Yamil-Serrano/16-Bit-Address-Accumulator-Register/KiCad/Address Accumulator Register.kicad_pcb

## KiCad design KiCad/Address Accumulator Register.kicad_pcb (2026-10-30)

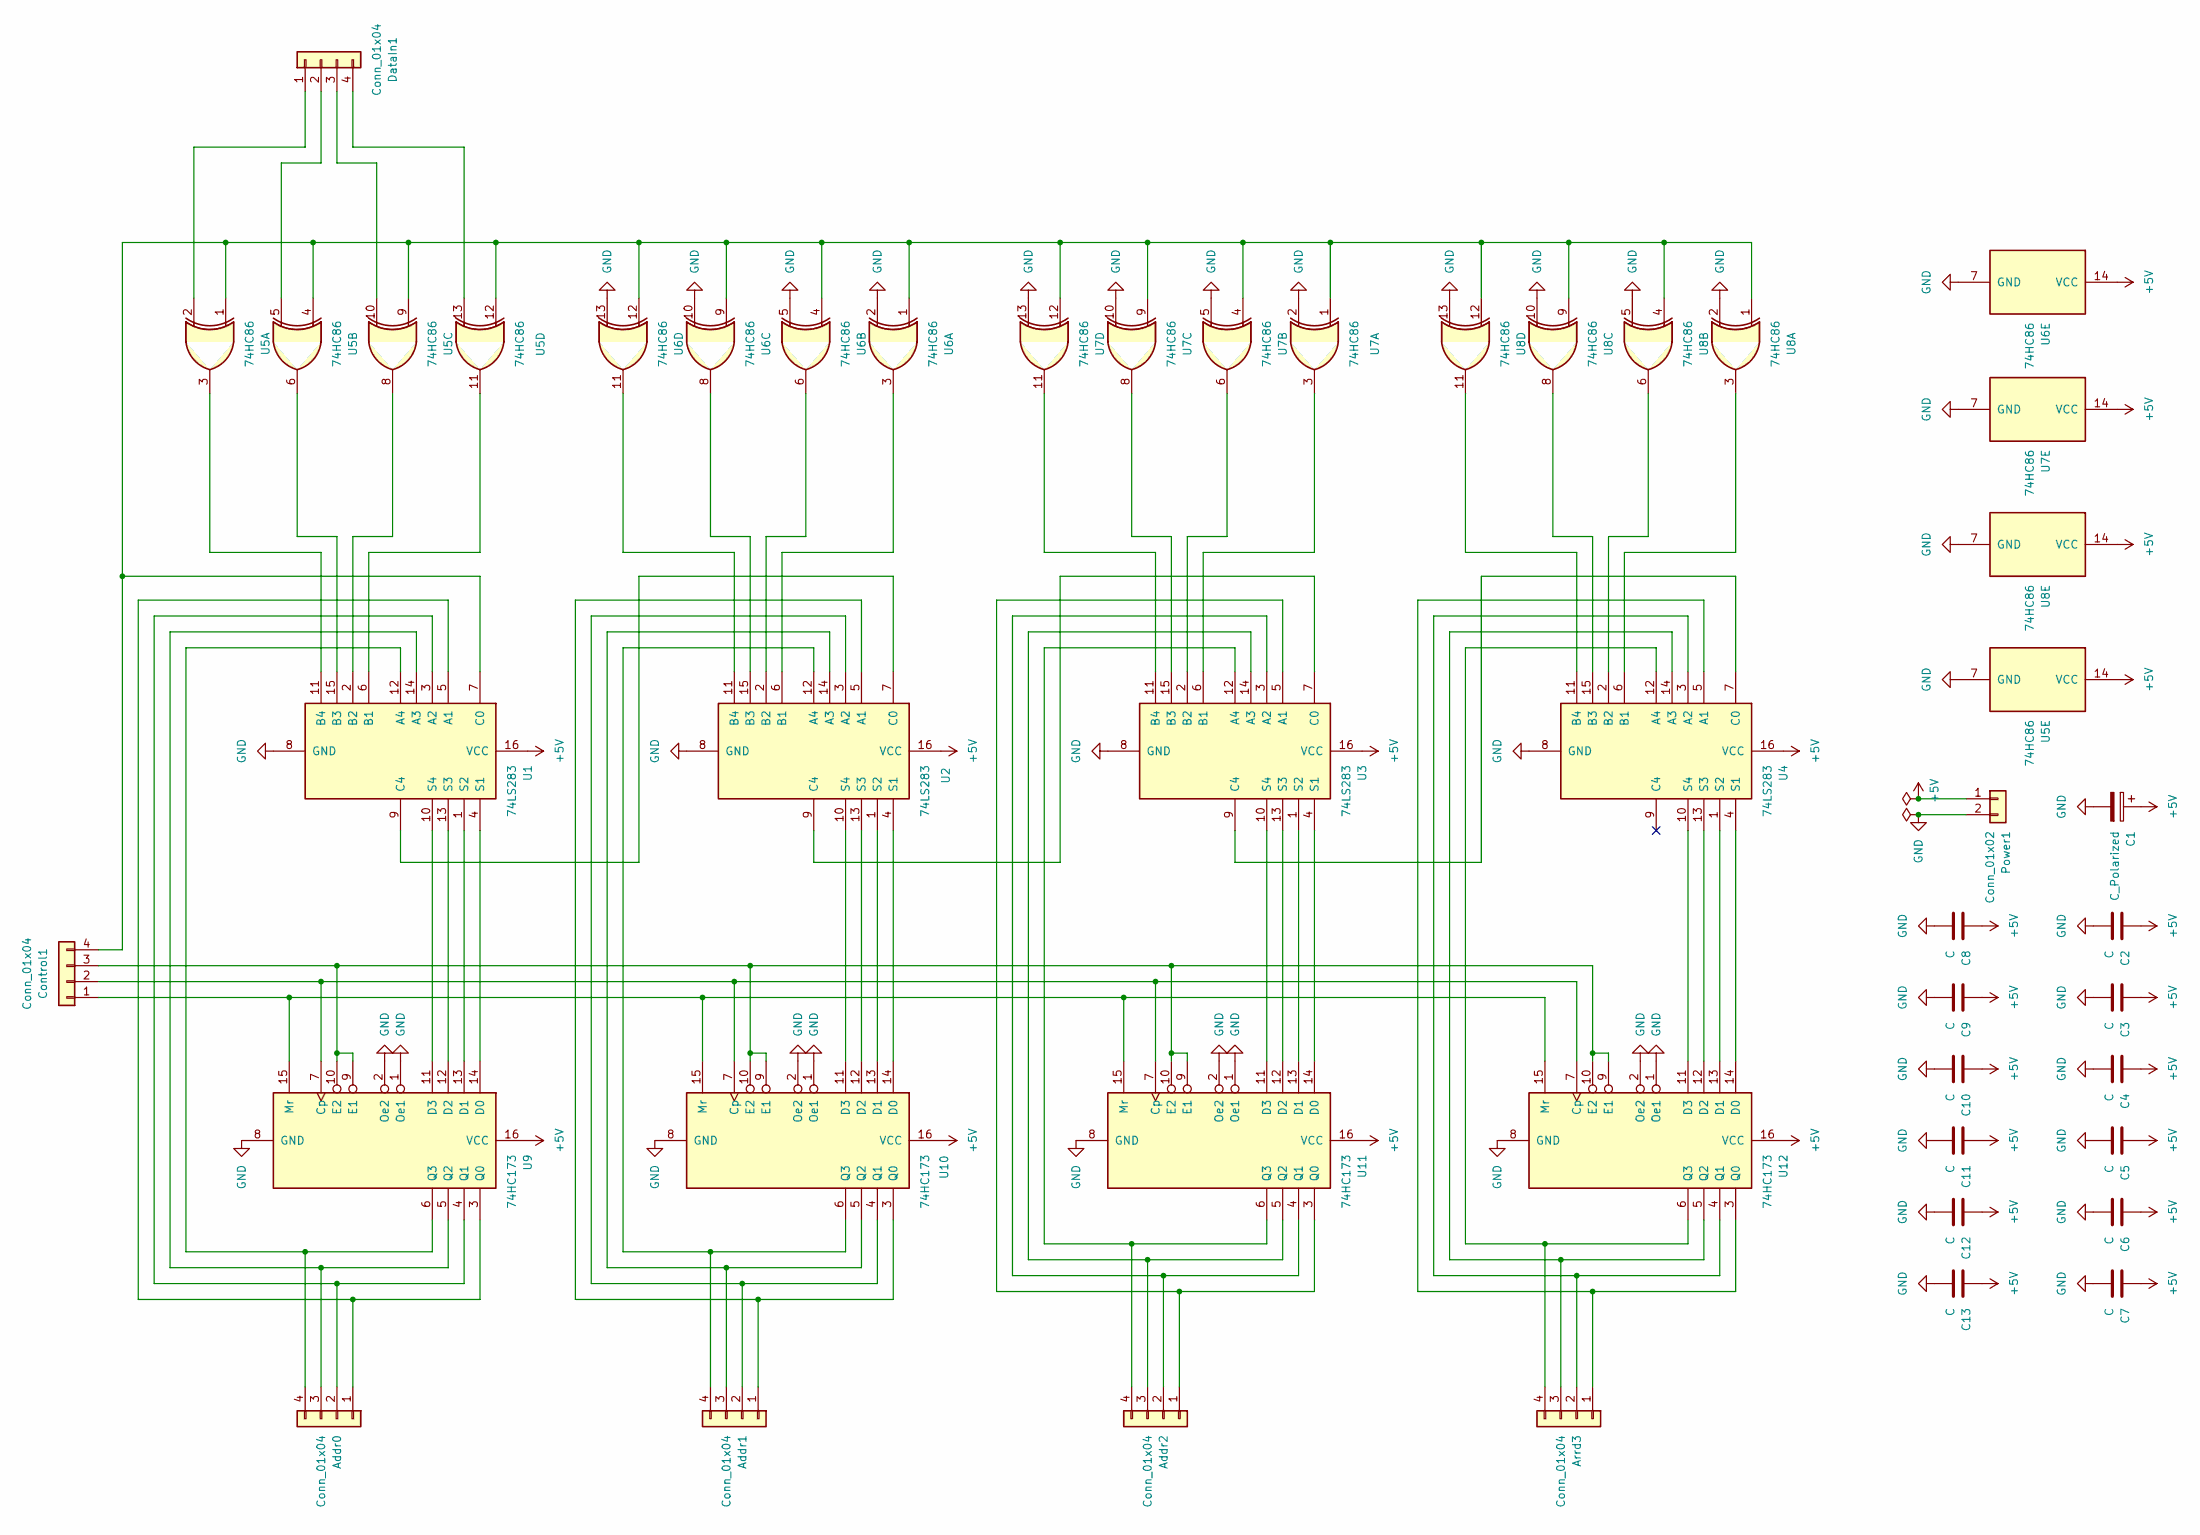
[picture p1: schematic Address Accumulator Register.kicad_sch, 16-Bit Address Accumulator Register]

Parts:
Addr0, Addr1, Addr2: Conn_01x04; PinHeader_1x04_P2.54mm_Vertical
Arrd3: Conn_01x04; PinHeader_1x04_P2.54mm_Vertical
C1: C_Polarized; CP_Radial_D4.0mm_P1.50mm
C2, C3, C4, C5, C6, C7, C8, C9, C10, C11, C12, C13: C; C_Disc_D3.0mm_W1.6mm_P2.50mm
Control1: Conn_01x04; PinHeader_1x04_P2.54mm_Vertical
DataIn1: Conn_01x04; PinHeader_1x04_P2.54mm_Vertical
Power1: Conn_01x02; PinHeader_1x02_P2.54mm_Vertical
U1, U2, U3, U4: 74LS283; DIP-16_W7.62mm_Socket
U5, U6, U7, U8: 74HC86; DIP-14_W7.62mm_Socket
U9, U10, U11, U12: 74HC173; DIP-16_W7.62mm_Socket

Connections:
+5V: C1.1, C2.1, C3.1, C4.1, C5.1, C6.1, C7.1, C8.1, C9.1, C10.1, C11.1, C12.1, C13.1, Power1.1, U1.16 (VCC), U2.16 (VCC), U3.16 (VCC), U4.16 (VCC), U5.14 (VCC), U6.14 (VCC), U7.14 (VCC), U8.14 (VCC), U9.16 (VCC), U10.16 (VCC), U11.16 (VCC), U12.16 (VCC)
GND: C1.2, C2.2, C3.2, C4.2, C5.2, C6.2, C7.2, C8.2, C9.2, C10.2, C11.2, C12.2, C13.2, Power1.2, U1.8 (GND), U2.8 (GND), U3.8 (GND), U4.8 (GND), U5.7 (GND), U6.2, U6.5, U6.7 (GND), U6.10, U6.13, U7.2, U7.5, U7.7 (GND), U7.10, U7.13, U8.2, U8.5, U8.7 (GND), U8.10, U8.13, U9.1 (Oe1), U9.2 (Oe2), U9.8 (GND), U10.1 (Oe1), U10.2 (Oe2), U10.8 (GND), U11.1 (Oe1), U11.2 (Oe2), U11.8 (GND), U12.1 (Oe1), U12.2 (Oe2), U12.8 (GND)
unnamed: Addr0.1, U1.5 (A1), U9.3 (Q0)
unnamed: Addr0.2, U1.3 (A2), U9.4 (Q1)
unnamed: Addr0.3, U1.14 (A3), U9.5 (Q2)
unnamed: Addr0.4, U1.12 (A4), U9.6 (Q3)
unnamed: Addr1.1, U2.5 (A1), U10.3 (Q0)
unnamed: Addr1.2, U2.3 (A2), U10.4 (Q1)
unnamed: Addr1.3, U2.14 (A3), U10.5 (Q2)
unnamed: Addr1.4, U2.12 (A4), U10.6 (Q3)
unnamed: Addr2.1, U3.5 (A1), U11.3 (Q0)
unnamed: Addr2.2, U3.3 (A2), U11.4 (Q1)
unnamed: Addr2.3, U3.14 (A3), U11.5 (Q2)
unnamed: Addr2.4, U3.12 (A4), U11.6 (Q3)
unnamed: Arrd3.1, U4.5 (A1), U12.3 (Q0)
unnamed: Arrd3.2, U4.3 (A2), U12.4 (Q1)
unnamed: Arrd3.3, U4.14 (A3), U12.5 (Q2)
unnamed: Arrd3.4, U4.12 (A4), U12.6 (Q3)
unnamed: Control1.1, U9.15 (Mr), U10.15 (Mr), U11.15 (Mr), U12.15 (Mr)
unnamed: Control1.2, U9.7 (Cp), U10.7 (Cp), U11.7 (Cp), U12.7 (Cp)
unnamed: Control1.3, U9.9 (E1), U9.10 (E2), U10.9 (E1), U10.10 (E2), U11.9 (E1), U11.10 (E2), U12.9 (E1), U12.10 (E2)
unnamed: Control1.4, U1.7 (C0), U5.1, U5.4, U5.9, U5.12, U6.1, U6.4, U6.9, U6.12, U7.1, U7.4, U7.9, U7.12, U8.1, U8.4, U8.9, U8.12
unnamed: DataIn1.1, U5.2
unnamed: DataIn1.2, U5.5
unnamed: DataIn1.3, U5.10
unnamed: DataIn1.4, U5.13
unnamed: U1.6 (B1), U5.11
unnamed: U1.2 (B2), U5.8
unnamed: U1.15 (B3), U5.6
unnamed: U1.11 (B4), U5.3
unnamed: U1.9 (C4), U2.7 (C0)
unnamed: U1.4 (S1), U9.14 (D0)
unnamed: U1.1 (S2), U9.13 (D1)
unnamed: U1.13 (S3), U9.12 (D2)
unnamed: U1.10 (S4), U9.11 (D3)
unnamed: U2.6 (B1), U6.3
unnamed: U2.2 (B2), U6.6
unnamed: U2.15 (B3), U6.8
unnamed: U2.11 (B4), U6.11
unnamed: U2.9 (C4), U3.7 (C0)
unnamed: U3.6 (B1), U7.3
unnamed: U3.2 (B2), U7.6
unnamed: U3.15 (B3), U7.8
unnamed: U3.11 (B4), U7.11
unnamed: U3.9 (C4), U4.7 (C0)
unnamed: U4.6 (B1), U8.3
unnamed: U4.2 (B2), U8.6
unnamed: U4.15 (B3), U8.8
unnamed: U4.11 (B4), U8.11
unnamed: U2.4 (S1), U10.14 (D0)
unnamed: U2.1 (S2), U10.13 (D1)
unnamed: U2.13 (S3), U10.12 (D2)
unnamed: U2.10 (S4), U10.11 (D3)
unnamed: U3.4 (S1), U11.14 (D0)
unnamed: U3.1 (S2), U11.13 (D1)
unnamed: U3.13 (S3), U11.12 (D2)
unnamed: U3.10 (S4), U11.11 (D3)
unnamed: U4.4 (S1), U12.14 (D0)
unnamed: U4.1 (S2), U12.13 (D1)
unnamed: U4.13 (S3), U12.12 (D2)
unnamed: U4.10 (S4), U12.11 (D3)

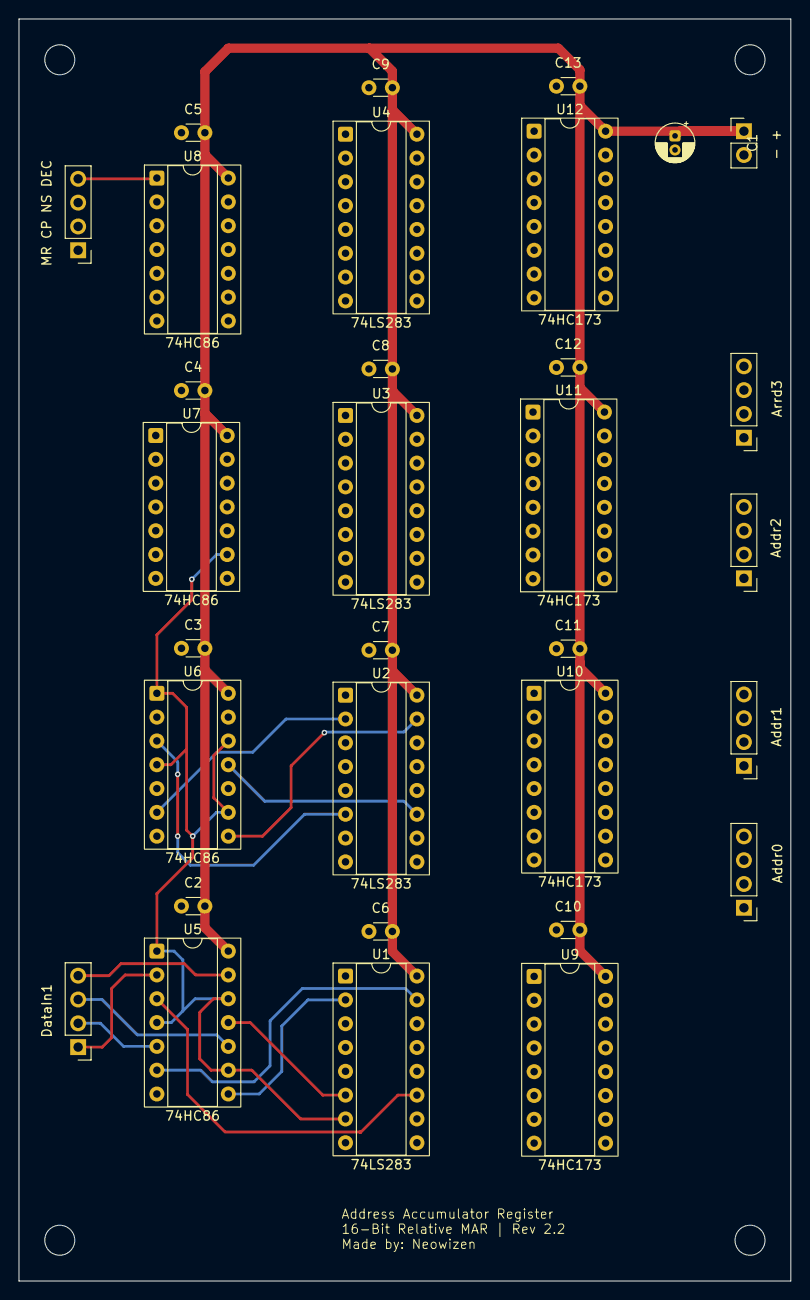
[picture p2: board Address Accumulator Register.kicad_pcb from above]

Board: 2 copper layers, 82.3 x 134.6 mm, 32 parts (0 on the bottom side), 61 nets.
